bigtreetech/BIGTREETECH-Kraken/Hardware/BIGTREETECH Kraken V1.0-SIZE.png

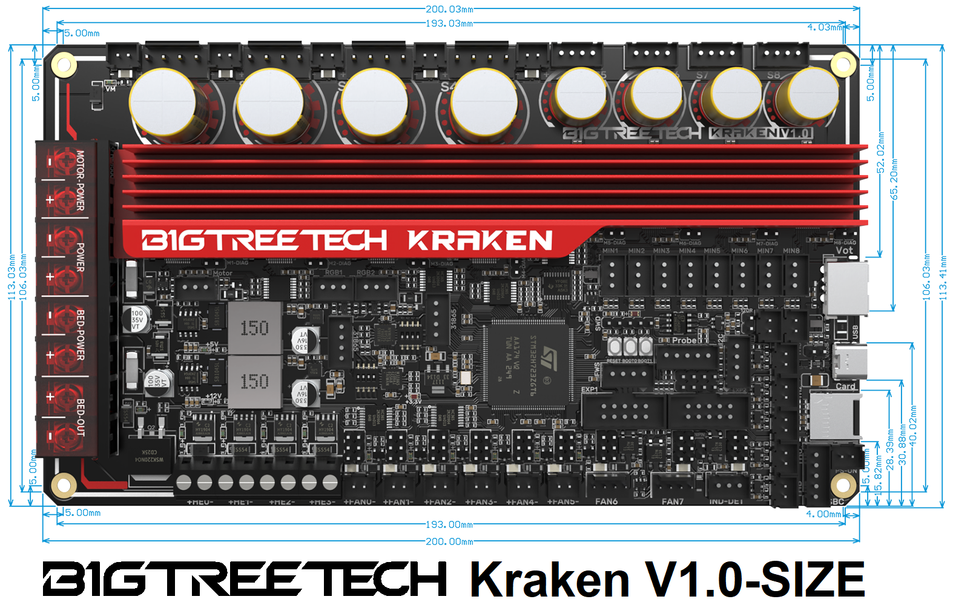
Hardware/BIGTREETECH Kraken V1.0-SIZE.png
