bigtreetech/BIGTREETECH-Kraken/Hardware/Kraken V1.0-Interface diagram .jpg

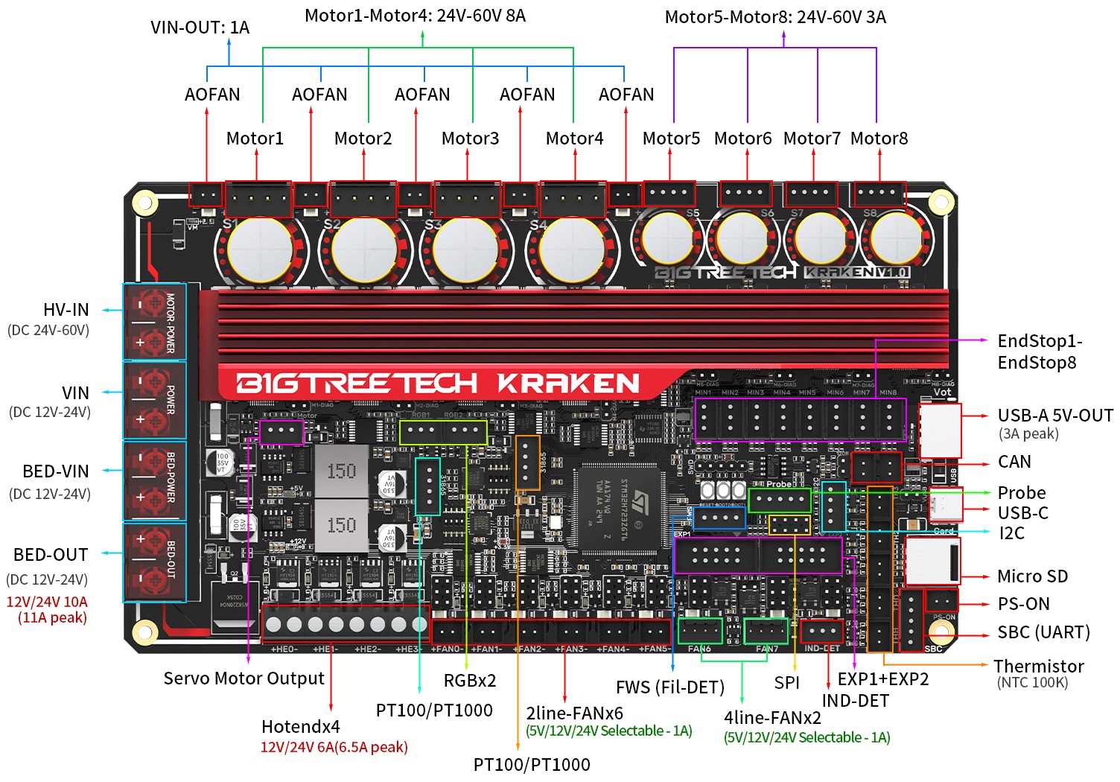
Hardware/Kraken V1.0-Interface diagram .jpg
