bigtreetech/BIGTREETECH-Kraken/3D/moutns.md

Use it together with https://github.com/VoronDesign/Voron-2/blob/Voron2.4/STLs/Electronics_Bay/pcb_din_clip_x3.stl
