bigtreetech/BIGTREETECH-Kraken/3D/Kraken V1.0 Mount.STEP

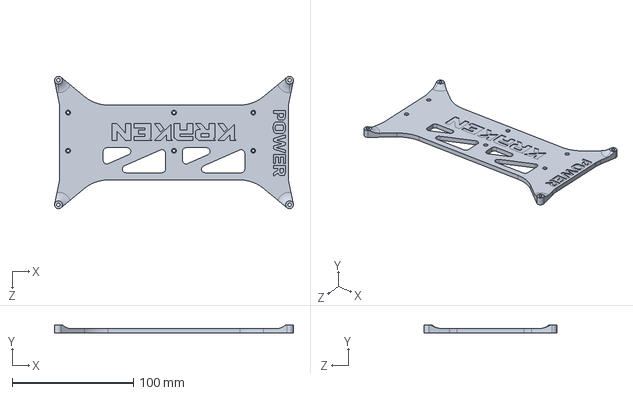
[picture p3: CAD file, 2024-01-24]
3D/Kraken V1.0 Mount.STEP
197.5 x 7.00 x 109.5 mm
