bigtreetech/BIGTREETECH-Kraken/(list of files, cad)

Other CAD files:
3D/Kraken V1.0 Mount.STL
