bigtreetech/BIGTREETECH-Kraken/Hardware/BIGTREETECH Kraken V1.0-SCH.pdf

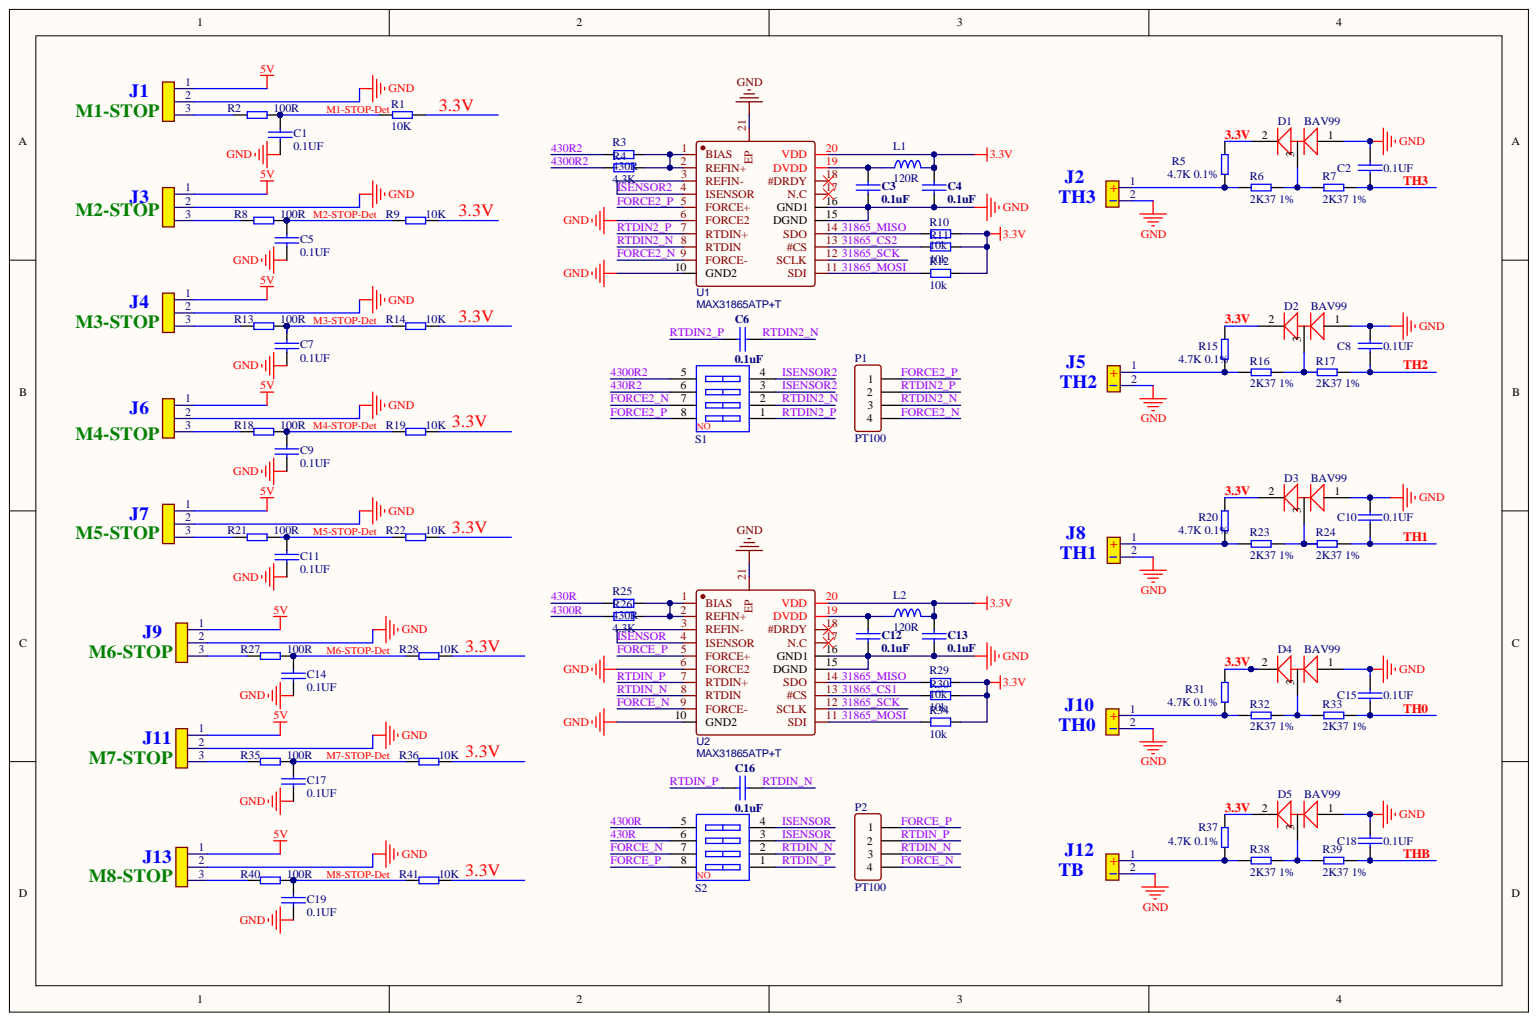
[picture p4: page 1]

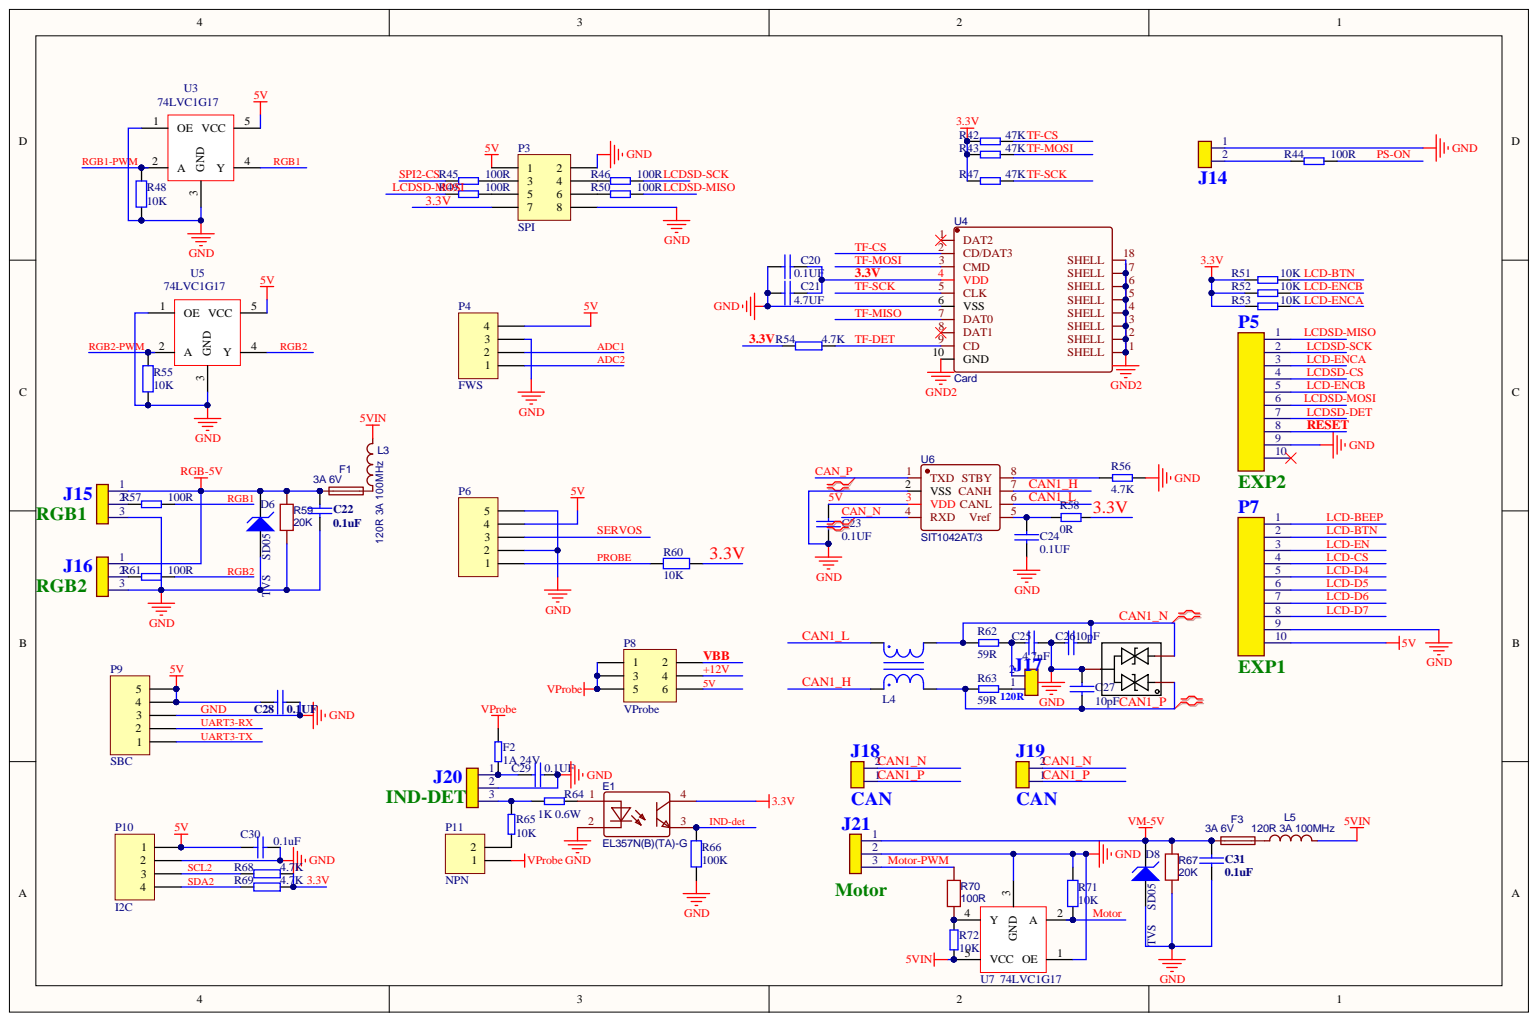
[picture p5: page 2]

PROBE 1

3 Motor-PWM

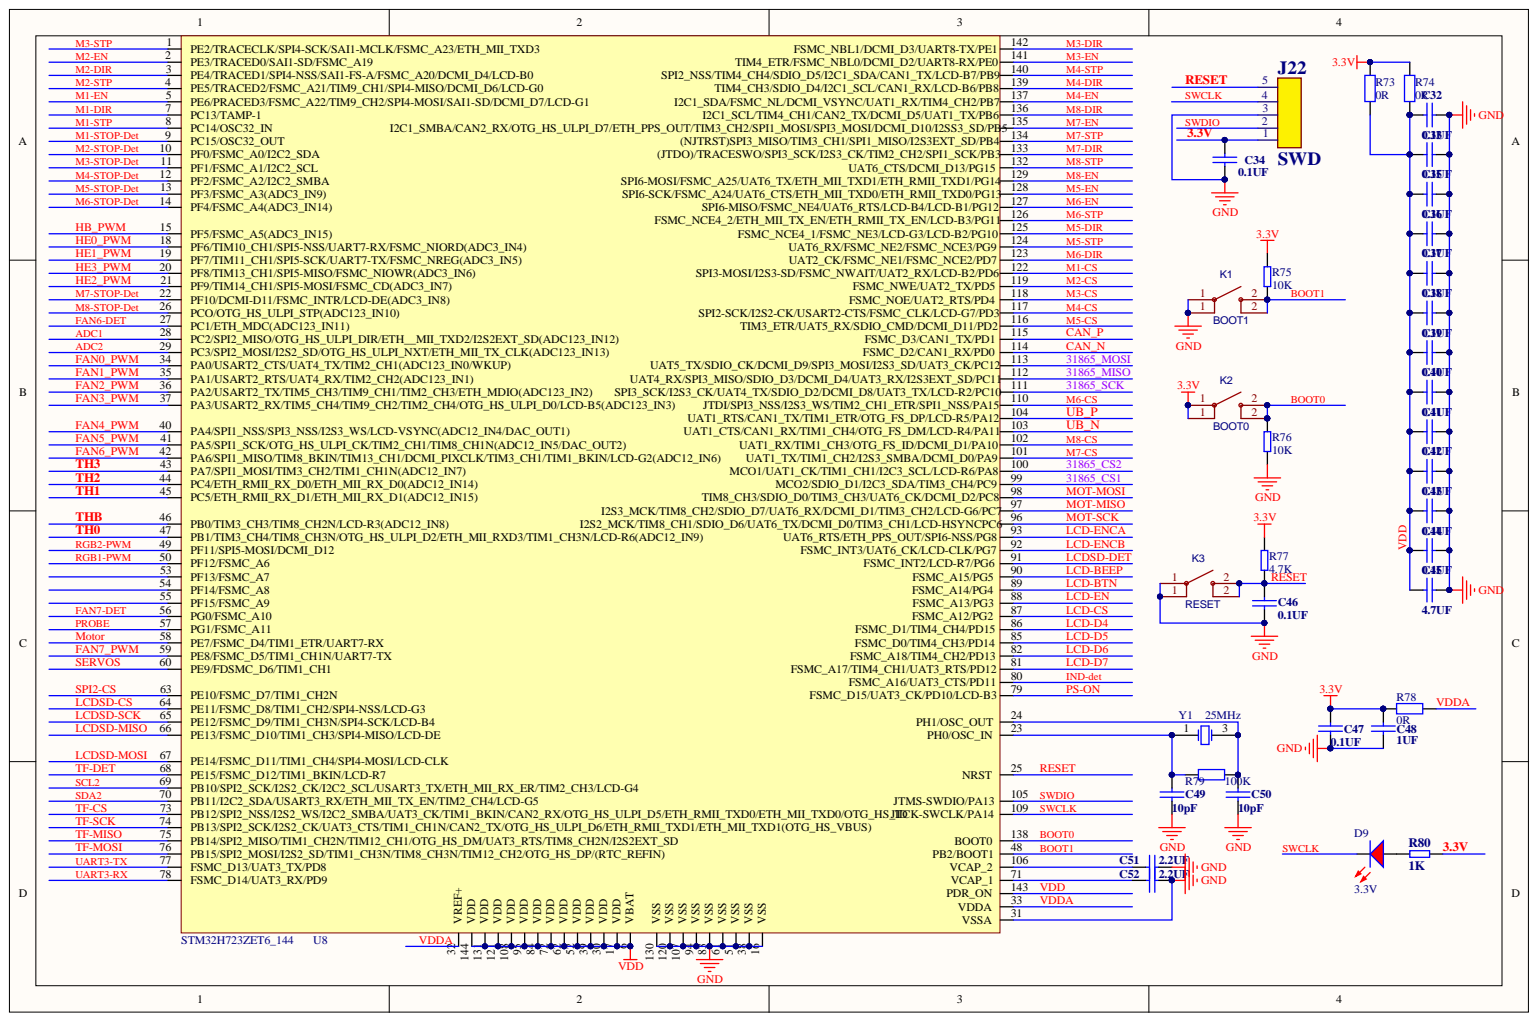
[picture p6: page 3]

MOT-MOSI MOT-MISO MOT-SCK

7 1 C 5 2 | 2.2 U
VDD VDDA 3 3 3 1

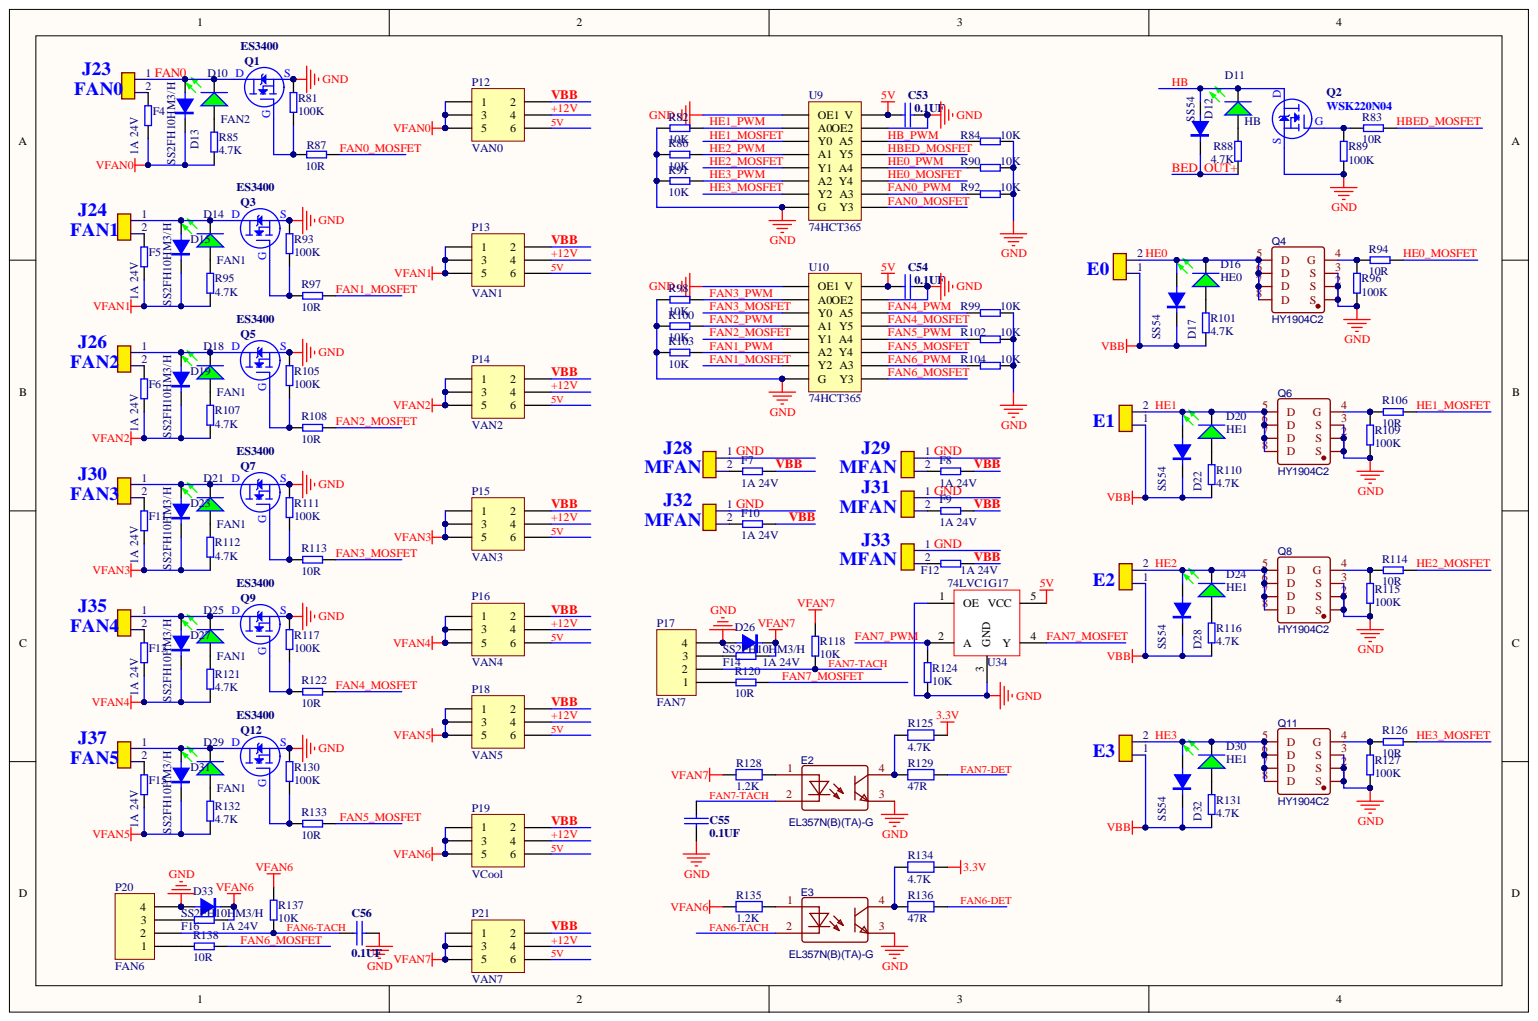
[picture p7: page 4]

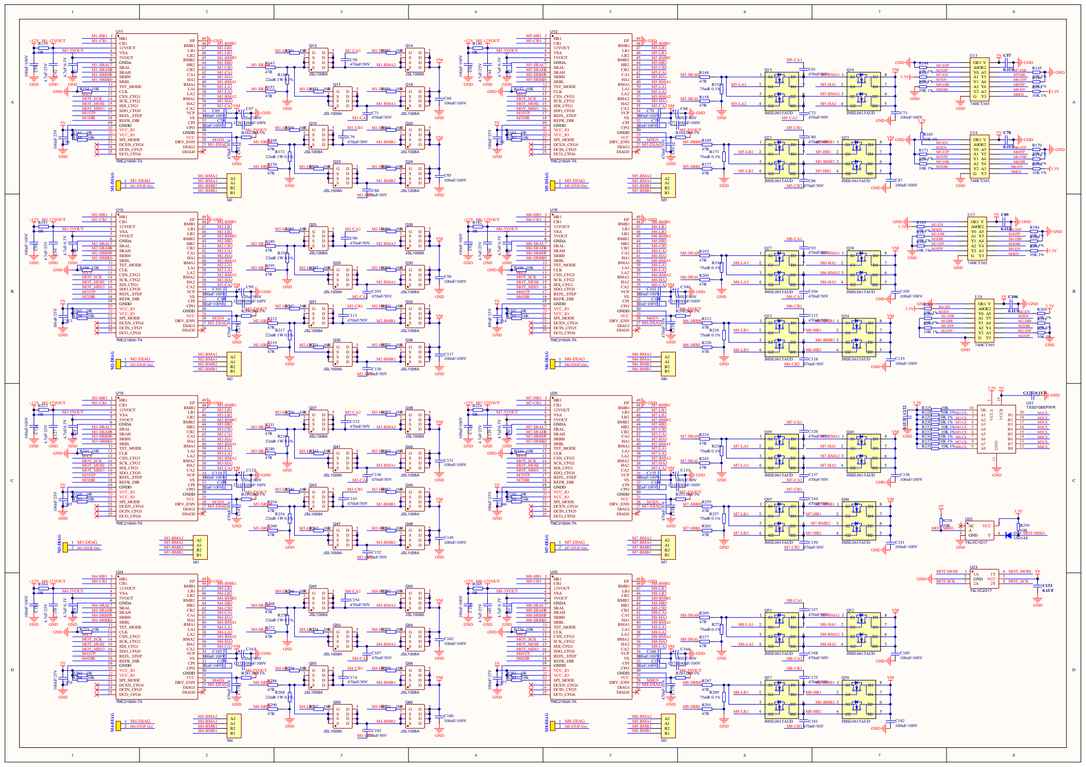
[picture p8: page 5]

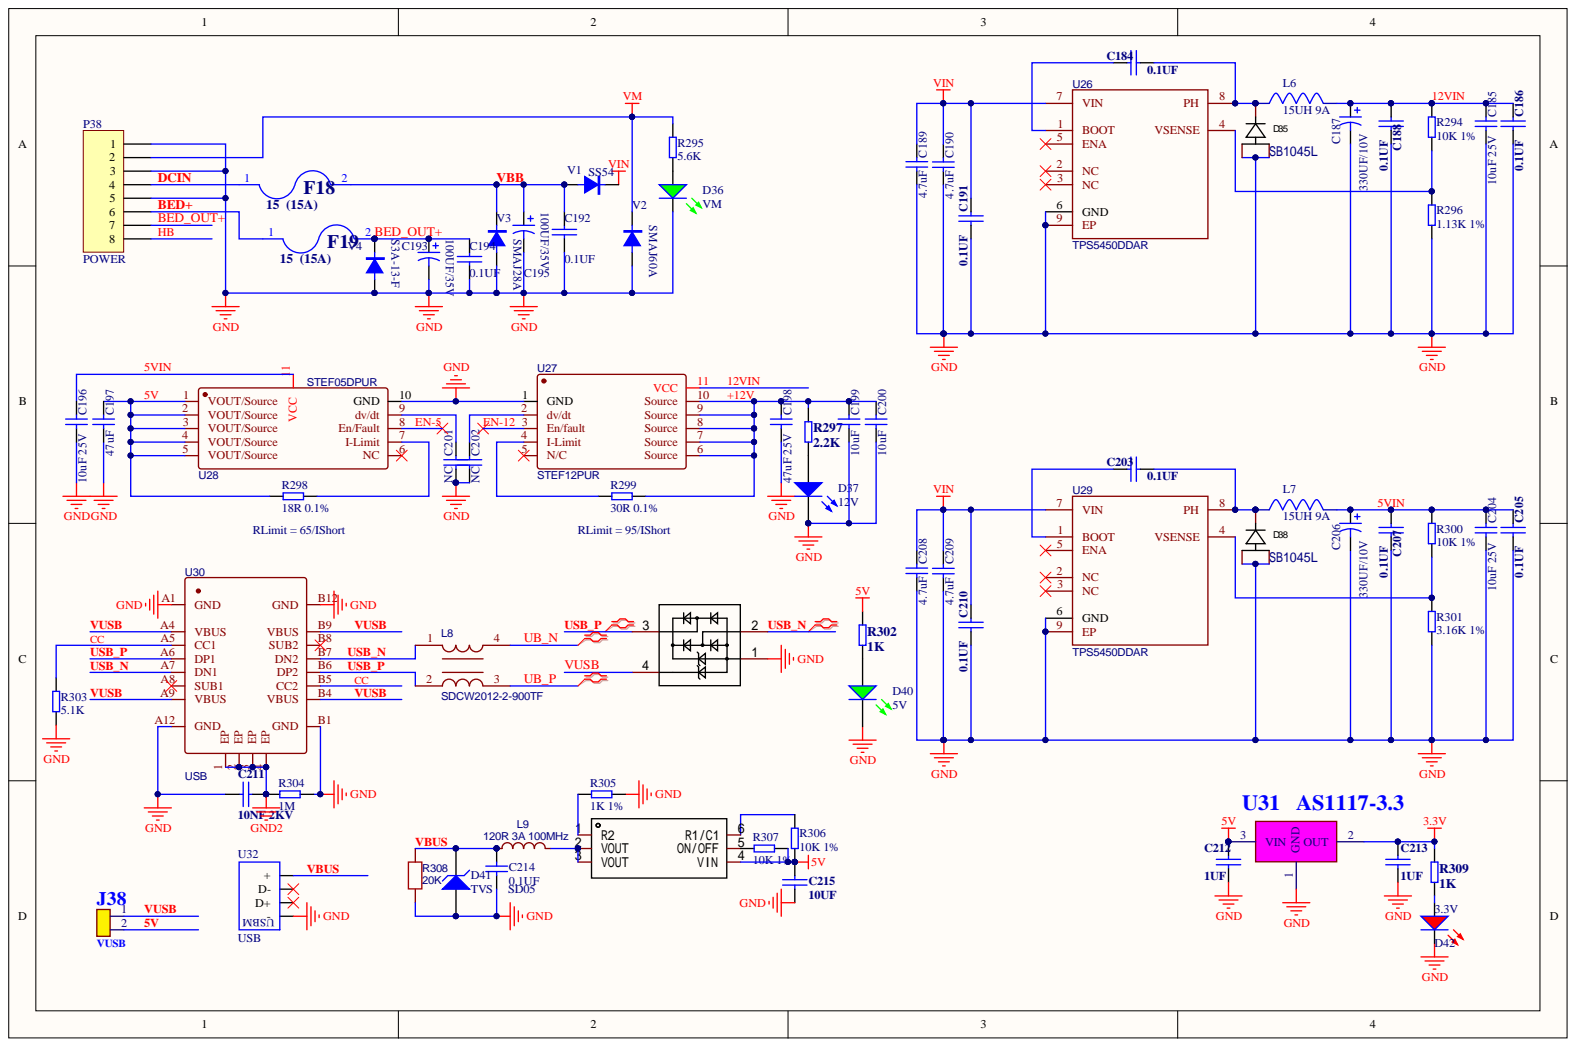
[picture p9: page 6]

VIN

DCIN
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
