bigtreetech/BIGTREETECH-Kraken/(threads)

Thread 1 (2024-01-03):

Incorrect cad for kraken

Jbori347, 2024-01-03:
The kraken step file does not match the actual board.

jimberg98, 2024-04-11:
The dimensions in the size image are also confusing. The top width dimension says 200.3 mm while the bottom says 200 mm. The left height dimension says 113.03 mm and the right dimension says 113.42. Are those correct?

BTTJUSTIN, 2024-05-29:
The documentation has been updated. Thanks again for pointing out the issue.

Closed 2024-05-29.

Thread 2 (2024-01-14):

reports error: DRV_STATUS: 001f5008 sg_result=8 s2vsa=1(ShortToSupply_A!)

evilskinny, 2024-01-14:
running a voron trident.  I kept getting the above error message for Z1 so i switched it from motor port 6 to 8.  Now im getting the same error for Z2 which is on motor port 7.  any ideas.  here is the complete klipper error.
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

looxonline, 2024-03-22:
> running a voron trident. I kept getting the above error message for Z1 so i switched it from motor port 6 to 8. Now im getting the same error for Z2 which is on motor port 7. any ideas. here is the complete klipper error. ![Capture](https://private-user-images.githubusercontent.com/58640343/296527708-86b222bd-ed04-4de7-9bcb-56fe3bfa938b.JPG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)

We have seen this before when someone was using the incorrect motor sense resistor value and the driver was trying to output 4 x the required current in order to get the needed feedback signal. This triggered the supply short warning. Check your sense values.

BTTJUSTIN, 2024-05-23:
Thanks for reaching out. Our support team does not operate using the GitHub
platform but we would be happy to help you via email based ticketing system. Please visit
https://biqu.equipment/pages/technical-support and submit a ticket and we will be in touch with you soon.

Closed 2024-05-23.

Thread 4 (2024-01-24):

Adding the board environment & firmware for Marlin?

BoothyBoothy, 2024-01-24:
Is there any plans to add Marlin firmware for the Kraken?

Would like to utilise the increased driver power options with Nema 23 motors on my CNC router.

Thanks in advance

Boothy

thisiskeithb, 2024-01-28:
Support was added last month: https://github.com/MarlinFirmware/Marlin/commit/c485f513d70acc838b7a1554c955fdaf5ef3df7f

Grab the latest [`bugfix-2.1.x`](https://github.com/MarlinFirmware/Marlin/archive/bugfix-2.1.x.zip) and use `BOARD_BTT_KRAKEN_V1_0`.

BoothyBoothy, 2024-01-28:
Yes Thank You for the Heads Up

thisiskeithb, 2024-05-23:
@BTTJUSTIN: The Kraken has been added to upstream Marlin so this issue can be closed.

Closed 2024-05-24.

Thread 5 (2024-02-03):

Is there a description of how to use onboard canbus?

altraWeb, 2024-02-03:
There are two canbus ports on this board but i can't find any howto's / Description to use that for example with an EBB SB2209.

Thanks for any help

Jbori347, 2024-02-14:
you need to flash the board with Katapult and set it in usb to can bridge mode.
you can follow instructions here: https://github.com/Esoterical/voron_canbus/tree/0bbde71d092cf38e8d3855190a9cf860a7f238ab

RyanBuzar, 2024-04-28:
> you need to flash the board with Katapult and set it in usb to can bridge mode. you can follow instructions here: https://github.com/Esoterical/voron_canbus/tree/0bbde71d092cf38e8d3855190a9cf860a7f238ab

I flashed catapult per the catapult instructions. I can't get the board out of DFU mode. The DFU mode LED is on, but when I check dfu-utils -l there aren't any controllers in DFU.

The documentation for this board is awful. I've had to get general information from other user guides to try to piece together information. For a "Premium" board, this is really sub-par documentation.

GKSN, 2024-09-04:
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

Hi!
So... I'm having a good learning curve regarding "Kraken and the CAN", until now I wasn't able to make it work but I think I got the direction right this time ( maybe not haha ), the main thing is that I wanted to use the Rpi UART mode comms with the CANBUS function and for what I can see or for what I cannot see it's that it's a little more complicated than I would like...
Getting back to the problem, I think I had the same problem as you, although I don't know if it is the same problem, the partial solution ( since it is not what will make the CAN BUS work ) is that you have to rewrite the default firmware to the mainboard (available in this repository ). The LED from the DFU Mode is locked in the ON state but I could put the board on DFU Mode as usual, after I followed the instructions from this repository and used the [command](https://github.com/bigtreetech/BIGTREETECH-Kraken/tree/master/Firmware#writing-bootloader-for-kraken-v10): `sudo dfu-util -d ,0483:df11 -R -a 0 -s 0x8000000:leave -D ./Kraken_H723_bootloader.bin` the board came back to life :-). Now I will try to make everything the right way ( or at least try ), for now, I will use the Rpi USB to communicate with the KRAKEN using it as a CAN bridge, by far the best tutorial I saw about is the **[ESOTERICAL GUIDE](https://canbus.esoterical.online/)** mentioned above.
I hope everything went well with your board, I'm writing all of this since it could help someone like me.
PS: If someone knows how to make the KRAKEN use UART to talk to the Rpi and at the same time work as a CAN bridge please let me know :-).

Thread 6 (2024-03-03):

3D Model Fixing Holes incorrect?

BoothyBoothy, 2024-03-03:
The top two fixing holes appear to be incorrect in the 3D model compared to the Unit I received
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
.

Jbori347, 2024-03-27:
Yea I've been asking for an accurate cad for a while now

BoothyBoothy, 2024-03-28:
> Yea I've been asking for an accurate cad for a while now

If of any use, you can find my simplified massing model with the correct holes fixings @ the link below. Best Boothy
https://www.dropbox.com/scl/fi/7l8dt1qe8xlcu022lw5sm/BIGTREETECH-Kraken-V1-Massing-Model-with-correct-hole-fixings-V1.step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

Thread 7 (2024-03-03):

Using a BTT serial Touch Screen Display with the Kraken

BoothyBoothy, 2024-03-03:
Hi,

Can you use a BTT serial Display in Touch Screen Mode?
I use an old 35TFT display in touch screen mode rather than emulated mode on my CNC machine for general jogging and tweaking settings. I use Marlin to drive my CNC so any Klipperscreen derivative is not relevant to my personal use case.
I am now upgrading my steppers and using a Kraken to drive new Nema 23 motors.
Is there any way I can connect the serial cable to the Kraken to drive the display in Touch Screen mode rather than emulated mode?
Using the Touch Screen Mode is much more efficient for the processes I am using.
Alternatively are there any BTT displays or equivalent that I can use with the Kraken that anyone knows of?

BoothyBoothy, 2024-03-28:
FYI for anyone else using a Touch Display in Marlin with the Kraken V1. I have got the a BTT 35TFT Touch Screen to work by connecting the serial connector to the SBC port on the Kraken but swapping the RX & TX pins on the connector.

Credit to Teamgloomy\RRF support pages for this solution: https://teamgloomy.github.io/tft.html

Closed 2024-03-28.

Thread 9 (2024-03-18):

Cannot get a BTT Mini 12684 display to work with Marlin on the Kraken

BoothyBoothy, 2024-03-18:
Hi All,
I am testing a Kraken with Marlin on a DIY CNC machine.
I find it useful to have some form of display for ease of tweaking settings when tuning or jogging the axis for general maintenance.
I just cannot get the Mini display or the neo pixels to work at all with the Kraken with Marlin firmware?
I have tried many different combinations in the Marlin firmware including selecting other generic Mini display options with zero response.
On earlier control boards I have used an old BTT touchscreen which has been perfect for my use case but this does not appear possible with no TFT connection for the board?
I am using the latest Kraken Marlin branch form the Marlin git.
Anyone any ideas?
Thanks in advance
Boothy

thisiskeithb, 2024-03-28:
I can confirm that none of the Mini 12864 displays with NeoPixels work on the Kraken under Marlin. The LCD lights up & NeoPixels will cycle on boot, but nothing is displayed. Using [`M250 C255`](https://marlinfw.org/docs/gcode/M250.html) to set max contrast also doesn't work.

Can you [file a bug report in the main Marlin repo](https://github.com/MarlinFirmware/Marlin/issues/new/choose) so this can be tracked? I'll do some more digging to see if I can get it working.

thisiskeithb, 2024-03-28:
Actually, simply add `#define FORCE_SOFT_SPI` anywhere in your config and that will work. I'll submit a PR to fix this bug upstream in Marlin shortly.

h/t to @ellensp for finding that missing define!

BoothyBoothy, 2024-03-28:
Thank You

Thread 10 (2024-03-22):

pin PB9 is reserved for CAN

wjcloudy, 2024-03-22:
Trying to use Stepper motor 4 - the step pin for this is connected to PB9 (confirmed by manual and sample config)

However klipper rejects this with the error: "pin PB9 is reserved for CAN"

Any ideas? (Schematic says can is on PD1 and PD0)

Thread 11 (2024-03-30):

TMC5160 or TMC2160?

tescolopio, 2024-03-30:
In the documentation you have labeled the stepper drivers as TMC2160 which doesn't match up with the configuration of TMC 5160. This is everywhere in the manual and marlin setup documentation. You can understand my confusion because I cannot find TMC5160 in the klipper documentation but... I can find a stepper drive TMC2160 developed by MKS.

Can you please clarify and correct in either case?

Thanks!

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

tescolopio, 2024-03-30:
Also, you have it listed as 2160 EVERYWHERE. Amazon, your website, advertising. But also it says 5160. Look at this picture. At the top it says 2160. Bottom says 5160. Thoughts?
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

tescolopio, 2024-03-31:
I realize that the architecture of the steppers are indeed TMC2160A-TA. I looked at the schematic. My question, to which I created a ticket with klipper with for as well, is do we need a specific config reference for the TMC2160 or is using the 5160 fine? Does this matter over time? Are there new features offered through the 2160 that should be configurable?

5jvm0u4, 2024-06-27:
I read form somewhere that TMC2160 has the same functionality and pinout as TMC5160, the only difference is TMC5160 has it's own built-in accel-decel control in one specific mode.

5jvm0u4, 2024-06-27:
I read it here, and I'm searching the same question as you are.
https://www.cnblogs.com/xing2/p/17457821.html

looxonline, 2024-06-27:
The drivers are functionally (and internally) identical. The 2160 simply has a part of the silicon that is not used in 3D printing untested and deactivated.

tescolopio, 2024-06-27:
Thanks for replying all. Much appreciated. I have been running with the 5160 drivers defined in my klipper and have had no issues.

Closed 2024-06-27.

Thread 13 (2024-04-29):

Need help for the I2C (Temp and humidity Sensor)

altraWeb, 2024-04-29:
On user manual there is a picture on how to connect this sensors with the board, i have actually hooked up one of this sensor.
But need some help / examples on how to use it from software / config site. There is an example in the cfg. but only one liner, do i need more for this to work or just this single line to activate / use it?

Sorry i'am relatively new to klipper especially in configuration stuff, Hope someone can spend a little time to further describe this.

Thanks a lot for any help / examples.

HaernCalistinson, 2024-07-26:
Here's mine

[temperature_sensor Chamber]
sensor_type: BME280
i2c_address: 118
i2c_mcu: mcu
i2c_bus: i2c2_PB10_PB11

Thread 14 (2024-05-12):

Manual needs clarification on Sensorless Homing & endstop pins

HumbleDeer, 2024-05-12:
## Problem

The endstop port's signal pin and the DIAG jumper's signal pin share the same I/O pin on the CPU, through a 100 ohm resistor.
The manual does not mention this explicitly.

## Demonstration

Both the endstop connectors used for mechanical switches as well as the DIAG pin headers meant for shorting together when using sensorless homing use the same signal line to the processor.

This causes problems when one has shorted this DIAG header for use with sensorless homing, while intending to hook up another device to the endstop "switch" connector.

In particular, common scenarios are using Normally Open switches going between signal and ground, with a pull-upresistor to VCC. In this scenario, the sensorless homing works fine until the mechanical switch is pressed and the DIAG signal is shorted to ground. Since the mechanical switch may be at the same location as where the sensorless homing triggers, this can cause pretty dramatic behaviour.

The following excerpts are from the [schematic PDF file](https://github.com/bigtreetech/BIGTREETECH-Kraken/blob/92f19e6f04c5ce2bd3fa09200e5593d87ca9a873/Hardware/BIGTREETECH%20Kraken%20V1.0-SCH.pdf) that can be found under the [Hardware](https://github.com/bigtreetech/BIGTREETECH-Kraken/tree/92f19e6f04c5ce2bd3fa09200e5593d87ca9a873/Hardware) folder:

| Endstop connector | DIAG header |
|-|-|
|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|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|

# Solution

The most straightforward resolution of this oversight would be to add a disclaimer to the section of the manual that describes the DIAG-pins, noting that the corresponding endstop connector can no longer be used once the DIAG pins have been shorted as instructed and sensorless homing is utilized.

## Notes

This issue was brought to my attention by user @Kobihikri, and documented by myself.

WO1984PR, 2024-07-30:
No response on this I assume. Having a problem with getting sensor less homing to be triggered. Been running in circles.

TrevTrev84, 2024-07-30:
> No response on this I assume. Having a problem with getting sensor less homing to be triggered. Been running in circles.

Set SGT to 1 and speed at 100.... just went through this and guys on Reddit helped!!

Thread 15 (2024-06-30):

Issue in the documentation with positive and negative HE Pins

OscarCid, 2024-06-30:
I am setting up my printer, and I found this inconsistency in the manual. Specifically, in the Pin Description section, I discovered that the positive and negative poles are reversed in the documentation.

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

This detail might cause issues for people connecting from those points to an SSR which is my case.

Thread 16 (2024-07-02):

How to connect Kraken to CB2

azaneff, 2024-07-02:
Hi, cant connect BTT Kraken + CB2 to klipper. Error: mcu 'mcu': Unable to connect.
I installed a cable between the SBC and the CB2, and entered the serial number of the mcu in the printer.cfg. I'm wrong somewhere, but I don't know where. I'm asking for help.

looxonline, 2024-07-02:
Hi. We don't use github as a support tool as it is not optimal for this purpose. We use it for customers to report firmware or hardware issues.

You will get great support from our facebook user group or from many of the discord user groups. If you would like to speak to a support technician then we encourage the use of the ticket tool which allows us to ensure that we follow up: https://biqu.equipment/pages/technical-support

Closed 2024-07-02.

Thread 19 (2024-10-05):

Need clarification on 48V to motors

DP4US, 2024-10-05:
Are all motors set to motor voltage in or just 1-4 if I'm using 48v in for the motors? Also how does this change the sense_resistor for S1-8?

jackwakefield, 2024-12-25:
According to the [schematic](https://github.com/bigtreetech/BIGTREETECH-Kraken/blob/master/Hardware/BIGTREETECH%20Kraken%20V1.0-SCH.pdf), all motors use the HV motor power input.

Thread 21 (2024-12-06):

My mcu temp shows 500+ C since i have simply plugged in a new themistor

altraWeb, 2024-12-06:
What's going wrong here? i have added on simple thermistor to the board and after that it shows me in the Dashboard 500 - 510 C.

Can anyone see the whats going wrong? i have not changed any values in the config and before it was at max 50C !?!

Thanks for any help / answers
