bigtreetech/BIGTREETECH-Kraken/(commit log)

2024-01-24 Added DIN rail mount for Kraken (#3)
    * Mounts for Kraken V1.0
    [Kraken V1.0 Mount.STEP, Kraken V1.0 Mount.STL]
2024-05-14 add .step(include heat sink)
2025-12-26 Manual: Correct the line sequence identification of the proximity switch interface
